EdisonYagual/Sistema-Bioambiental-Transporte-Larvas/(list of files, drawings)

Other design files:
docs/esquematico/PCBCAMARONES.pdsprj
