EdisonYagual/Sistema-Bioambiental-Transporte-Larvas/(commit log)

2026-08-29 Eliminar codigo de pruebas comentado
2026-08-30 Diferenciar vistas web de computadora y celular
2026-08-30 Agregar documento de diseño en Markdown
2026-09-04 Documentar conexiones completas del ESP32
2026-09-04 Agregar esquematico y diseno PCB de Proteus
    [PCBCAMARONES.pdsprj]
2026-09-04 Aclarar descarga del proyecto de Proteus
